robot-head/PixelPusher-Ethernet-Extender-Shield/Far End/Far End.png

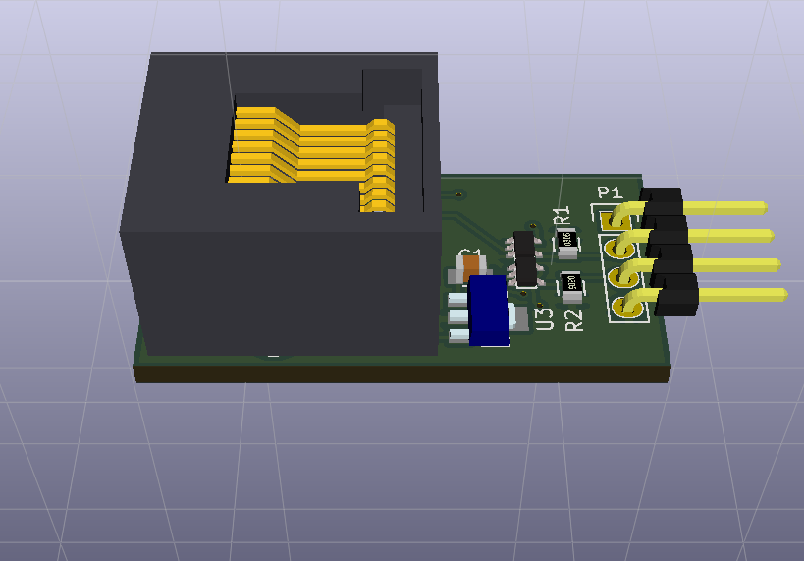
Far End/Far End.png
