robot-head/PixelPusher-Ethernet-Extender-Shield/(list of files, drawings)

Other design files:
Normal Polarity/Normal.dsn
Reverse Polarity/Reverse Polarity.dsn
