robot-head/PixelPusher-Ethernet-Extender-Shield/(commit log)

2015-05-26 Initial import
    [PixelPusher Eth Extender junk.kicad_pcb, PixelPusher Eth Extender junk.sch, PixelPusher-ethernet-extender-shield.sch, _saved_PixelPusher Eth Extender junk.sch]
2015-05-27 Check in reverse polarity board
    [Reverse Polarity.kicad_pcb, Reverse Polarity.sch, _saved_PixelPusher Eth Extender junk.sch]
2015-05-27 Made pour work properly
    [Reverse Polarity-B_Cu.gbr, Reverse Polarity-B_Mask.gbr, Reverse Polarity-B_SilkS.gbr, Reverse Polarity-Edge_Cuts.gbr, Reverse Polarity-F_Cu.gbr, Reverse Polarity-F_Mask.gbr, Reverse Polarity-F_SilkS.gbr, Reverse Polarity.drl]
2015-05-27 Fix up board so it doesn't have a ton of duplicates
    [Reverse Polarity.kicad_pcb]
2015-05-27 Revised to remove islands
    [Reverse Polarity-B_Cu.gbr, Reverse Polarity-B_Mask.gbr, Reverse Polarity-B_SilkS.gbr, Reverse Polarity-Edge_Cuts.gbr, Reverse Polarity-F_Cu.gbr, Reverse Polarity-F_Mask.gbr, Reverse Polarity-F_SilkS.gbr, Reverse Polarity.drl]
2015-05-28 Remove checked in gerbers
    [Reverse Polarity-B_Cu.gbr, Reverse Polarity-B_Mask.gbr, Reverse Polarity-B_SilkS.gbr, Reverse Polarity-Edge_Cuts.gbr, Reverse Polarity-F_Cu.gbr, Reverse Polarity-F_Mask.gbr, Reverse Polarity-F_SilkS.gbr, Reverse Polarity.drl]
2015-06-19 I had the ethernet plugs flopped, whoops
    [Reverse Polarity.kicad_pcb, Reverse Polarity.sch]
2015-06-19 Also update schematic
    [Reverse Polarity.sch]
2015-07-08 * Remove dead extender * Add normal polarity (which was what I was calling reverse polarity) * Fix reverse polarity to actually be reversed
    [Normal.dsn, Normal.kicad_pcb, Normal.sch, PixelPusher Eth Extender junk.kicad_pcb, PixelPusher Eth Extender junk.sch, PixelPusher-ethernet-extender-shield.sch, Reverse Polarity.kicad_pcb, Reverse Polarity.sch]
2015-07-09 Adding Far End
    [Far End.sch, Reverse Polarity.kicad_pcb]
2015-07-13 Far End properly ground twisted
    [Far End.kicad_pcb, Far End.sch]
